UMDBPP/LVC/README.md

# LVC
Low Voltage Cutoff Hardware for LiPo Battery Protection
