UMDBPP/LVC/Rev6p1/CAD/render/lvc_3d_top.png

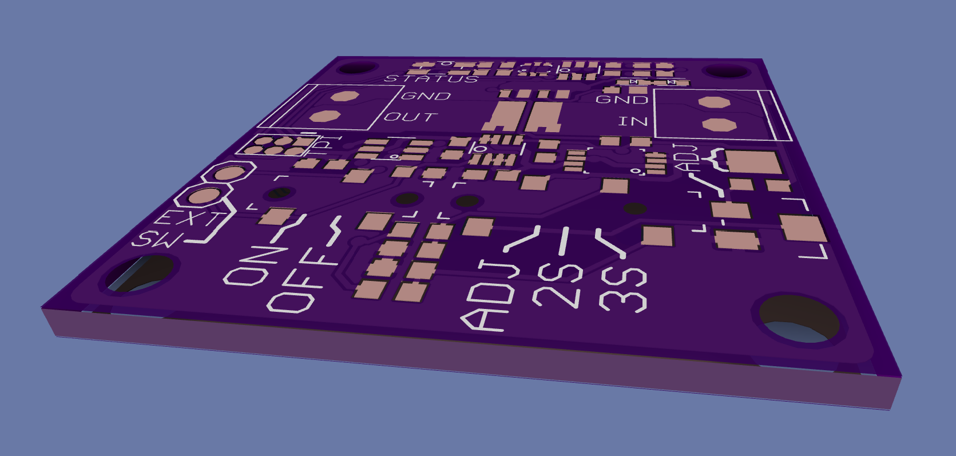
Rev6p1/CAD/render/lvc_3d_top.png
