UMDBPP/LVC/Rev6p1/CAD/render/lvc_bottom.png

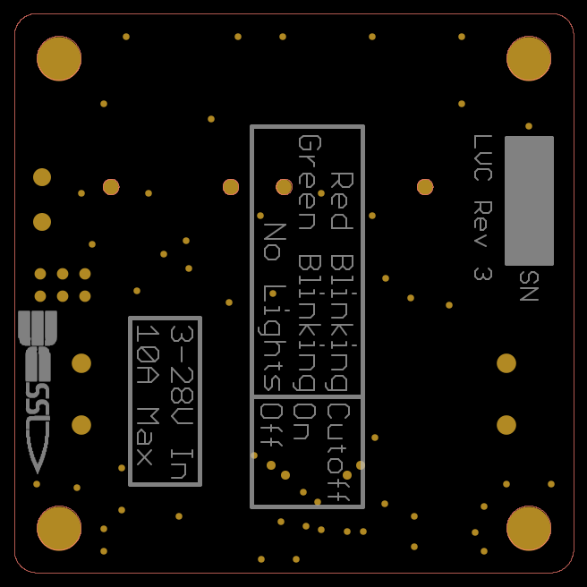
Rev6p1/CAD/render/lvc_bottom.png
