UMDBPP/LVC/Rev2025.0/LVC_Custom_BOM.xlsx

Country of Origin may be different at time of shipment.
The HTSUS and ECCN information shown is for informational purposes only and is not a representation or warranty as to the accuracy or reliability of these classifications. All information is provided "as is" and is subject to change without notice. Any use made of the information provided is without recourse to Digi-Key and at the user's risk.
Index | Manufacturer Part Number | Manufacturer Name | Description | Availability | Stock Status | Attrition % | Requested Quantity 1 | Pack Quantity 1 | Pack Type 1 | Digi-Key Part Number 1 | Unit Price 1 | Extended Price 1 | Minimum Order Quantity 1 | Customer Reference | Requested Part Number | Lead Weeks | Datasheet | Reference Designator | US Import Tariff | Note | Part Status | RoHS Status | Moisture Sensitivity Level (MSL) | ECCN | HTSUS | Country of Origin | Environmental Information | Original Part numbers | REACH Status | Unit of Measure | Image | Product Notes
1 | SMAZ10-13-F | Diodes Incorporated | DIODE ZENER 10V 1W SMA | 87,221 | In Stock |  | 1 | 1 | Cut Tape (CT) | SMAZ10-FDICT-ND | 0.31000 | $0.31 | 1 |  | SMAZ10-13-F | 12 | https://www.diodes.com/assets/Datasheets/ds18015.pdf |  | N/A |  | Active | ROHS3 Compliant | 1 (Unlimited) | EAR99 | 8541.10.0050 | Taiwan | https://www.diodes.com/assets/Quality-Reliability-Docs/Master_CofC.pdf | SMAZ10-13-F | REACH Unaffected | EACH | https://mm.digikey.com/Volume0/opasdata/d220001/medias/images/5787/31%7ESMA%7E%7E2-View-2.jpg
2 | 1812L300/24SLER | Littelfuse Inc. | PTC RESET FUSE 3.0A 24V 1812 | 2,307 | In Stock |  | 1 | 1 | Cut Tape (CT) | 18-1812L300/24SLERCT-ND | 2.07000 | $2.07 | 1 |  | 1812L300/24SLER | 13 | https://www.littelfuse.com/assetdocs/low-rho-datasheet-update?assetguid=b786faf0-de16-4763-9d22-6b8080943caf |  | N/A |  | Active | ROHS3 Compliant | 1 (Unlimited) | EAR99 | 8533.40.8070 | Taiwan |  | 1812L300/24SLER | REACH Unaffected | EACH | https://mm.digikey.com/Volume0/opasdata/d220001/medias/images/5596/MFG_1812L300_24SLER.jpg
3 | GSFC3415C | Good-Ark Semiconductor | MOSFET, P-CH, SINGLE, -4.00A, -2 | 10,102 | In Stock |  | 2 | 2 | Cut Tape (CT) | 4786-GSFC3415CCT-ND | 0.16000 | $0.32 | 1 |  | GSFC3415C | 16 | https://goodarksemi.com/docs/datasheets/mosfets/GSFC3415C.pdf |  | N/A |  | Active | ROHS3 Compliant | 1 (Unlimited) | EAR99 | 8541.29.0095 | China |  | GSFC3415C | REACH Unaffected | EACH | https://mm.digikey.com/Volume0/opasdata/d220001/medias/images/6145/MFG_4786_SOT-23.jpg
4 | CUS-13TB | Nidec Components Corporation | SWITCH SLIDE SP3T 300MA 4V | 26,326 | In Stock |  | 1 | 1 | Cut Tape (CT) | 563-1103-1-ND | 0.91000 | $0.91 | 1 |  | CUS-13TB | 10 | https://www.nidec-copal-electronics.com/e/catalog/switch/cus.pdf |  | N/A |  | Active | ROHS3 Compliant | 1 (Unlimited) | EAR99 | 8536.50.9050 | Vietnam |  | CUS-13TB | REACH Unaffected | EACH | https://mm.digikey.com/Volume0/opasdata/d220001/medias/images/852/CUS-13TB.jpg
5 | LT6703IDC-2#TRMPBF | Analog Devices Inc. | IC COMPARATOR 1 GEN PUR 3DFN | 929 | In Stock |  | 1 | 1 | Cut Tape (CT) | LT6703IDC-2#TRMPBFCT-ND | 2.75000 | $2.75 | 1 |  | LT6703IDC-2#TRMPBFCT-ND | 10 | https://www.analog.com/media/en/technical-documentation/data-sheets/670323fd.pdf |  | N/A |  | Active | ROHS3 Compliant | 1 (Unlimited) | EAR99 | 8542.39.0060 | Thailand | https://www.analog.com/media/en/material-declaration/LT6703IDC-2%23TRMPBF.PDF | LT6703IDC-2#TRMPBFCT-ND | REACH Unaffected | EACH | https://mm.digikey.com/Volume0/opasdata/d220001/medias/images/4994/505%7E05-08-1717%7EDC%7E3.JPG
6 | RN73H1JTTD1004B25 | KOA Speer Electronics, Inc. | RES 1M OHM 0.1% 1/10W 0603 | 21,518 | In Stock |  | 4 | 4 | Cut Tape (CT) | 2019-RN73H1JTTD1004B25CT-ND | 0.10000 | $0.40 | 1 |  | 2019-RN73H1JTTD1004B25CT-ND | 9 | https://www.koaspeer.com/pdfs/RN73H.pdf |  | N/A |  | Active | ROHS3 Compliant | 1 (Unlimited) | EAR99 | 8533.21.0030 | Japan | https://www.koaglobal.com/-/media/Files/KOA_Global/product/common/rohs/Certificate_of_RoHS_Compliance_July2024.pdf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|https://mm.digikey.com/Volume0/opasdata/d220001/medias/docus/5718/2019_KOA%20Speer%20RoHS3%20Statement.pdf | 2019-RN73H1JTTD1004B25CT-ND | REACH Unaffected | EACH | https://mm.digikey.com/Volume0/opasdata/d220001/medias/images/211/KOA-Speer-RN73H-0603.jpg
7 | RR0816P-154-D | Susumu | RES SMD 150K OHM 0.5% 1/16W 0603 | 177,041 | In Stock |  | 1 | 1 | Cut Tape (CT) | RR08P150KDCT-ND | 0.10000 | $0.10 | 1 |  | RR08P150KDCT-ND | 22 | https://www.susumu.co.jp/common/pdf/n_catalog_partition05_en.pdf |  | N/A |  | Active | ROHS3 Compliant | 1 (Unlimited) | EAR99 | 8533.21.0030 | Japan | https://www.susumu.co.jp/common/pdf/Certificate%20of%20EU%20RoHS%20compliance.pdf | RR08P150KDCT-ND | REACH Unaffected | EACH | https://mm.digikey.com/Volume0/opasdata/d220001/medias/images/2577/RR%200603%20SERIES.jpg
8 | ERA-3AEB683V | Panasonic Electronic Components | RES SMD 68K OHM 0.1% 1/10W 0603 | 20,290 | In Stock |  | 1 | 1 | Cut Tape (CT) | P68KDBCT-ND | 0.10000 | $0.10 | 1 |  | P68KDBCT-ND | 12 | https://industrial.panasonic.com/cdbs/www-data/pdf/RDM0000/AOA0000C307.pdf |  | N/A |  | Active | ROHS3 Compliant | 1 (Unlimited) | EAR99 | 8533.21.0030 | Japan | https://industrial.panasonic.com/cdbs/www-cgi/auto-publishing.cgi?type=ROSU&region=WW&layer=4&cd=AOA0026 | P68KDBCT-ND | REACH Unaffected | EACH | https://mm.digikey.com/Volume0/opasdata/d220001/medias/images/2391/10-0603%20Resistor.jpg
9 | ERA-3AEB4422V | Panasonic Electronic Components | RES SMD 44.2KOHM 0.1% 1/10W 0603 | 5,603 | In Stock |  | 1 | 1 | Cut Tape (CT) | 10-ERA-3AEB4422VCT-ND | 0.10000 | $0.10 | 1 |  | 10-ERA-3AEB4422VCT-ND | 12 | https://industrial.panasonic.com/cdbs/www-data/pdf/RDM0000/AOA0000C307.pdf |  | N/A |  | Active | ROHS3 Compliant | 1 (Unlimited) | EAR99 | 8533.21.0030 | Japan | https://industrial.panasonic.com/cdbs/www-cgi/auto-publishing.cgi?type=ROSU&region=WW&layer=4&cd=AOA0026 | 10-ERA-3AEB4422VCT-ND | REACH Unaffected | EACH | https://mm.digikey.com/Volume0/opasdata/d220001/medias/images/2391/10-0603%20Resistor.jpg
10 | RN73H1JTTD1002B25 | KOA Speer Electronics, Inc. | RES 10K OHM 0.1% 1/10W 0603 | 363,487 | In Stock |  | 1 | 1 | Cut Tape (CT) | 2019-RN73H1JTTD1002B25CT-ND | 0.10000 | $0.10 | 1 |  | 2019-RN73H1JTTD1002B25CT-ND | 9 | https://www.koaspeer.com/pdfs/RN73H.pdf |  | N/A |  | Active | ROHS3 Compliant | 1 (Unlimited) | EAR99 | 8533.21.0030 | Japan | https://www.koaglobal.com/-/media/Files/KOA_Global/product/common/rohs/Certificate_of_RoHS_Compliance_July2024.pdf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|https://mm.digikey.com/Volume0/opasdata/d220001/medias/docus/5718/2019_KOA%20Speer%20RoHS3%20Statement.pdf | 2019-RN73H1JTTD1002B25CT-ND | REACH Unaffected | EACH | https://mm.digikey.com/Volume0/opasdata/d220001/medias/images/211/KOA-Speer-RN73H-0603.jpg
11 | C0603C104K5RAC7411 | KEMET | CAP CER 0.1UF 50V X7R 0603 | 1,491,827 | In Stock |  | 1 | 1 | Cut Tape (CT) | 399-C0603C104K5RAC7411CT-ND | 0.08000 | $0.08 | 1 |  | 399-C0603C104K5RAC7411CT-ND | 20 | https://search.kemet.com/download/datasheet/C0603C104K5RAC7411 |  | N/A |  | Active | ROHS3 Compliant | 1 (Unlimited) | EAR99 | 8532.24.0020 | Mexico |  | 399-C0603C104K5RAC7411CT-ND | REACH Unaffected | EACH | https://mm.digikey.com/Volume0/opasdata/d220001/medias/images/5352/0603-%281608-Metric%29-Ceramic-Capacitor.jpg
