UMDBPP/LVC/tiny84/LVC_rev1/LVC_rev1_BOM.xlsx

UMD BPP Low Voltage Cutoff Rev 1.2 BOM
Item # | Ref Des | Qty | Manufacturer | Mfg Part # | Description | Package | Type | Dist. 1 | Dist. 1 Part No. | Dist. 2 | Dist. 2 Part No.
1 | C1 | 1 | Samsung EMA | CL31B475KBHNNNE | CAP CER 4.7UF 50V X7R 1206 | 1206 | SMD | Digi-Key | 1276-2789-1-ND
2 | C2 | 1 | Samsung EMA | CL21A106KOQNNNE | CAP CER 10UF 16V X5R 0805 | 0805 | SMD | Digi-Key | 1276-1096-1-ND
3 | C3 | 1 | Murata | GRM188R71E104KA01D | 0.10µF ±10% 25V X7R Ceramic Capacitor | 0603 | SMD | Digi-Key | 490-1524-1-ND
4 | LED1 | 1 | YETDA | 5060BRG4 | LED RGB Common Cathode |  | SMD | Sparkfun | COM-10866
5 | R1, 2, 3 | 3 |  |  | 1M, 0.1% | 0603 | SMD | Digi-Key | A102234CT-ND
6 | R4 | 1 |  |  | 1k, 5% | 0603 | SMD | Digi-Key | 311-1.0KGRCT-ND
7 | R5, 6, 7, 11, 12, 13 | 6 |  |  | 100k, 5% | 0603 | SMD | Digi-Key | 311-100KGRCT-ND
8 | R8, 9, 10 | 3 |  |  | 680, 5% | 0603 | SMD | Digi-Key | 1276-5058-1-ND
9 | U1 | 1 | Micrel | MIC5239-5.0YM | IC REG LDO 5V 0.5A 8SOIC | 8-SOIC | SMD | Digi-Key | 576-1838-5-ND
10 | U2 | 1 | Atmel | ATTINY84-20SSU | IC MCU 8BIT 8KB FLASH 14SOIC | 14-SOIC | SMD | Digi-Key | ATTINY84-20SSU-ND
11 | T1 | 1 | Diodes Incorporated | DMP4047SK3-13 | MOSFET P-CH 40V 20A TO252 | TO-252 | SMD | Digi-Key | DMP4047SK3-13DICT-ND
12 | T2, 4 | 2 | NXP | 2N7002P,215 | MOSFET N-CH 60V 0.36A SOT-23 | SOT23-3 | SMD | Digi-Key | 568-5818-1-ND
13 | T3 | 1 | Infineon | BSS84PH6327XTSA2 | MOSFET P-CH 60V 170MA SOT-23 | SOT23 | SMD | Digi-Key | BSS84PH6327XTSA2CT-ND
14 | S1, 2 | 2 | Sparkfun |  | SPDT Slide Switch |  | Thru-Hole | Sparkfun | COM-09609
15 | PRGM | 1 | Sparkfun | PRT-12807 | 6 Pin programming header |  | Thru-Hole | Sparkfun | PRT-12807
16 | J1 |  |  |  | 5 pin linear header 0.1" spacing |  |  |  | Do not populate
17
18
19
20
21
22
