UMDBPP/LVC/Rev6p1/CAD/eagle/lvc_schematic.pdf

Dividers | Screw Terminals

A

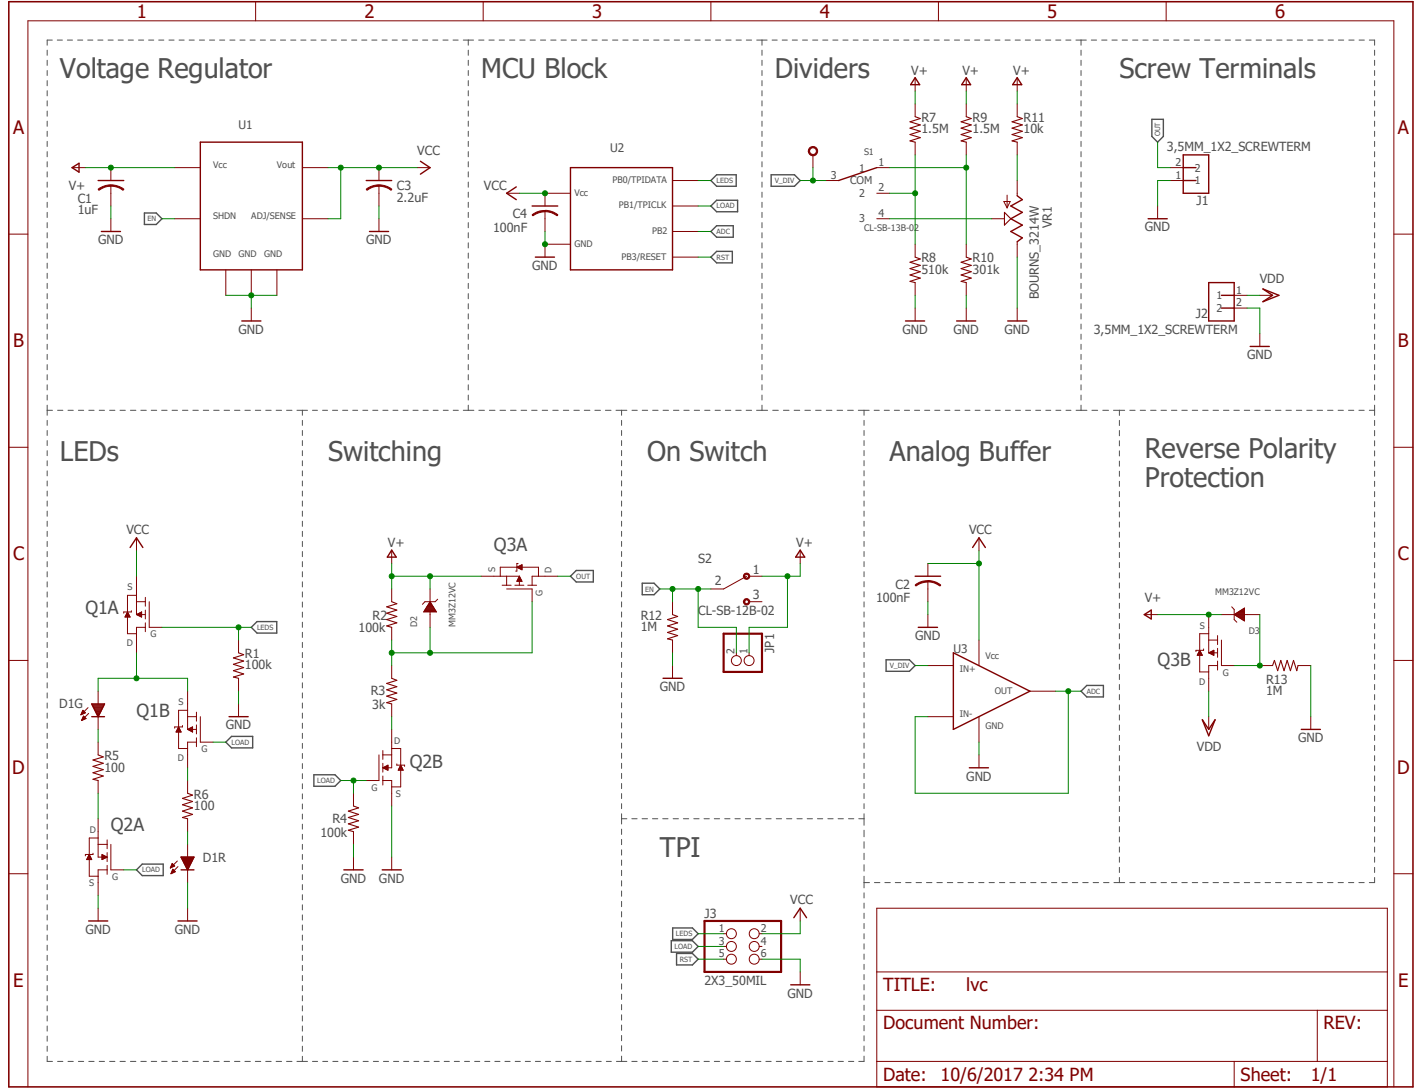
[picture p4: page 1]

Voltage Regulator MCU Block

Document Number: | REV:

Date: 10/6/2017 2:34 PM | Sheet: 1/1
