UMDBPP/LVC/Rev2025.0/LVC_Custom.kicad_pcb

## KiCad design Rev2025.0/LVC_Custom.kicad_pcb (2025-04-04)

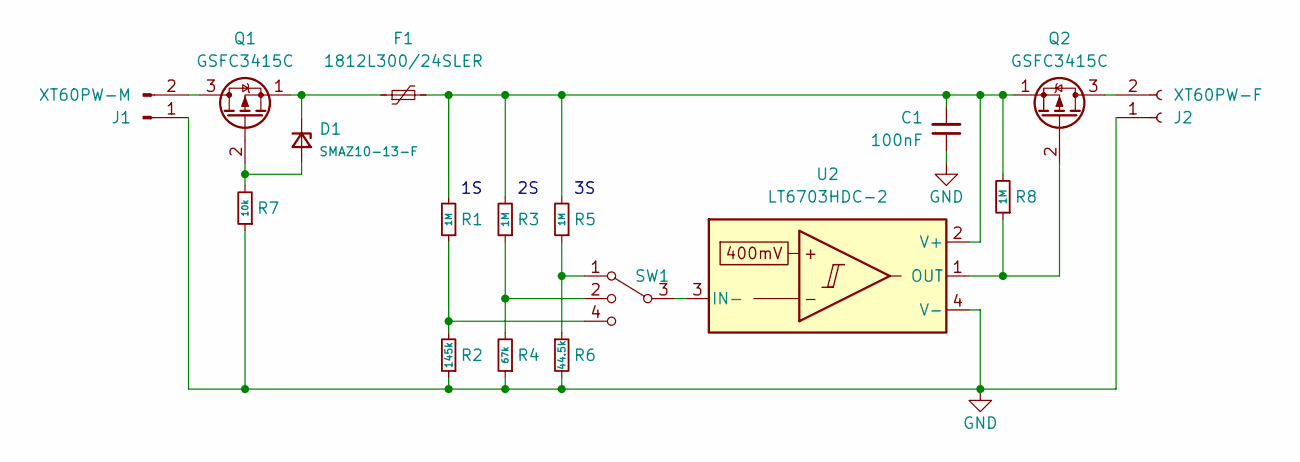
[picture p5: schematic LVC_Custom.kicad_sch, Low Voltage Cutoff]

Parts:
C1: 100nF; C_0603_1608Metric_Pad1.08x0.95mm_HandSolder
D1: SMAZ10-13-F; D_SMA_Handsoldering
F1: 1812L300/24SLER; Fuse_1812_4532Metric_Pad1.30x3.40mm_HandSolder
J1: XT60PW-M; AMASS_XT60PW-M_1x02_P7.20mm_Horizontal
J2: XT60PW-F; AMASS_XT60PW-F_1x02_P7.20mm_Horizontal
Q1, Q2: GSFC3415C; SOT-23-3
R1, R3, R5, R8: 1M; R_0603_1608Metric_Pad0.98x0.95mm_HandSolder
R2: 145k; R_0603_1608Metric_Pad0.98x0.95mm_HandSolder
R4: 67k; R_0603_1608Metric_Pad0.98x0.95mm_HandSolder
R6: 44.5k; R_0603_1608Metric_Pad0.98x0.95mm_HandSolder
R7: 10k; R_0603_1608Metric_Pad0.98x0.95mm_HandSolder
SW1: CUS-13TB; CUS-13TB_NDC
U2: LT6703HDC-2; DFN-3-1EP-2x2mm_P0.5mm_EP1x1.35mm

Connections:
GND: C1.1, J1.1, J2.1, R2.1, R4.1, R6.2, R7.1, U2.4 (V-)
unnamed: D1.2 (A), Q1.2 (G), R7.2
unnamed: D1.1 (K), F1.1, Q1.1 (S)
unnamed: J1.2, Q1.3 (D)
unnamed: J2.2, Q2.3 (D)
unnamed: Q2.2 (G), R8.1, U2.1 (OUT)
unnamed: C1.2, F1.2, Q2.1 (S), R1.2, R3.2, R5.2, R8.2, U2.2 (V+)
unnamed: R1.1, R2.2, SW1.4
unnamed: R3.1, R4.2, SW1.2
unnamed: R5.1, R6.1, SW1.1
unnamed: SW1.3, U2.3 (IN-)

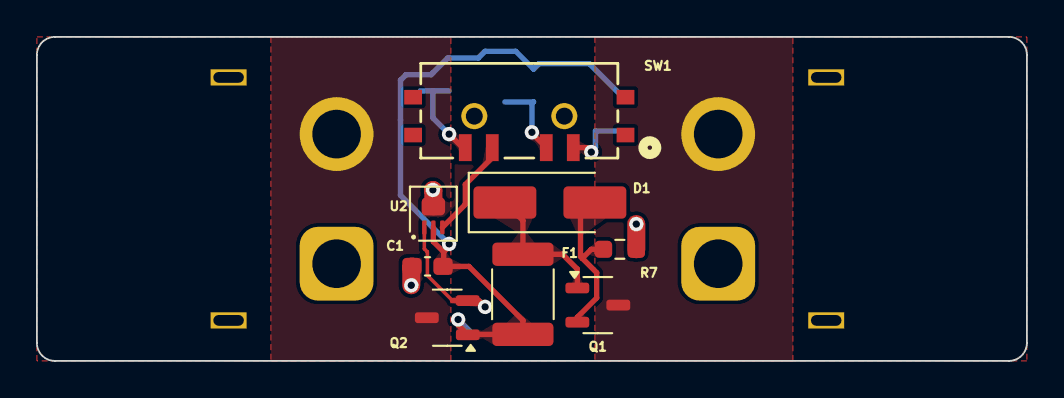
[picture p6: board LVC_Custom.kicad_pcb from above]

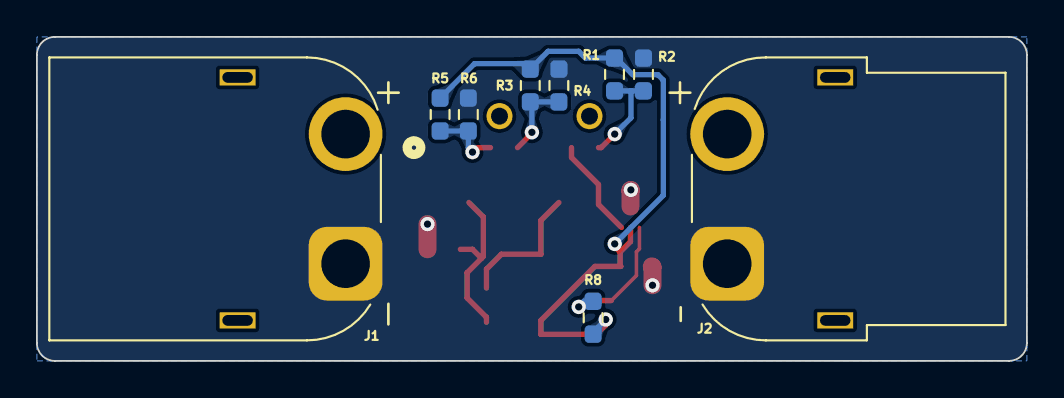
[picture p7: board LVC_Custom.kicad_pcb from below]

Board: 2 copper layers, 55.0 x 18.0 mm, 17 parts (9 on the bottom side), 11 nets.
