UMDBPP/LVC/Rev6p1/CAD/eagle/lvc.brd

## EAGLE design Rev6p1/CAD/eagle/lvc.brd (2018-05-23)

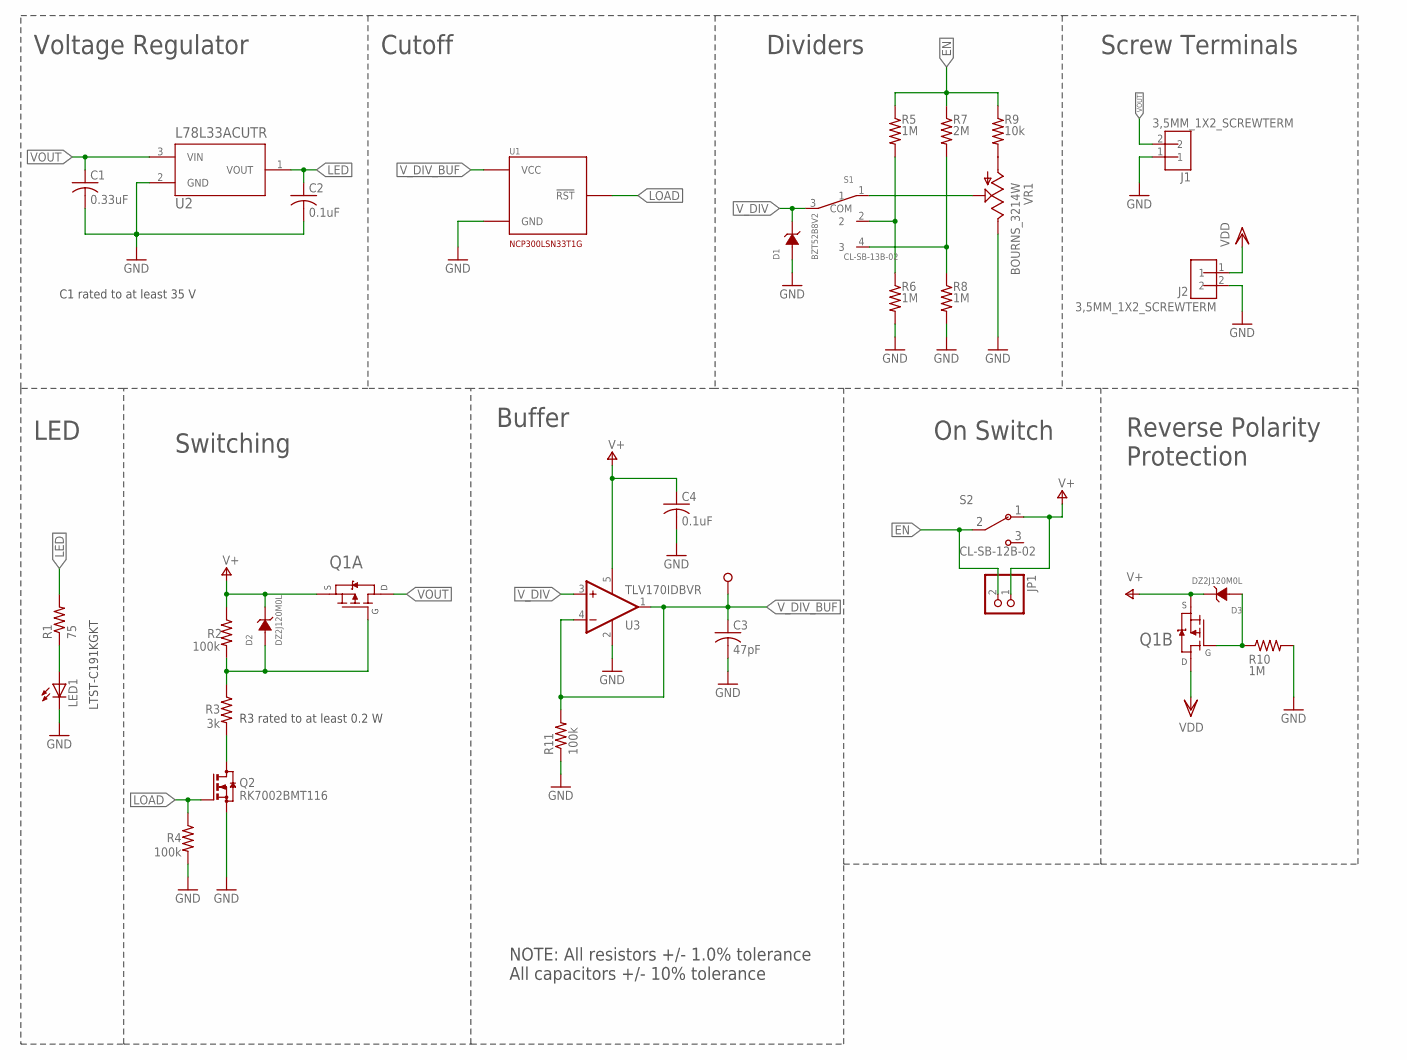
[picture p8: schematic lvc.sch]

Parts:
C1: 0.33uF; C0603
C2, C4: 0.1uF; C0603
C3: 47pF; C0603
D1: BZT52B8V2; SOD123
D2, D3: DZ2J120M0L; SMINI2-F5-B
J1, J2: 3,5MM_1X2_SCREWTERM; 3.5MM_1X2
JP1: PINHD-1X2; 1X02
LED1: LEDCHIPLED_0603; CHIPLED_0603
Q1: SI7997DP; POWERPAK-SO-8-DUAL
Q2: RK7002BMT116; SOT23
R1: 75; R0603
R2, R4, R11: 100k; R0603
R3: 3k; R0603
R5, R6, R8, R10: 1M; R0603
R7: 2M; R0603
R9: 10k; R0603
S1: CL-SB-13B-02; CL-SB-13B
S2: CL-SB-12B-02; CL-SB-12B
TP2: TESTPOINTNOCREAM; TP_2.5MM_NOCREAM
U1: NCP300LSN33T1G; SOT23-5
U2: L78L33ACUTR; SOT-89
U3: TLV170IDBVR; SOT23-DBV
VR1: BOURNS_3214W; J-LEAD_TOP_ADJ

Connections:
2_CELL: R5.2, R6.1, S1.2
3_CELL: R7.2, R8.1, S1.4 (3)
EN: JP1.2, R5.1, R7.1, R9.1, S2.1
GND: C1.2, C2.2, C3.2, C4.2, D1.A, J1.1, J2.2, LED1.C, Q2.2 (S), R4.2, R6.2, R8.2, R10.2, R11.1, U1.3 (GND), U2.2 (GND), U3.2 (V-), VR1.3 (E)
LED: C2.1, R1.2, U2.1 (VOUT)
LOAD: Q2.1 (G), R4.1, U1.1 (!RST!)
unnamed: LED1.A, R1.1
unnamed: D2.A, Q1.4 (G), R2.2, R3.1
unnamed: D3.A, Q1.2 (G), R10.1
unnamed: Q2.3 (D), R3.2
unnamed: S1.1, VR1.2 (S)
unnamed: R9.2, VR1.1 (A)
V+: C4.1, D2.C, D3.C, JP1.1, Q1.1 (S), Q1.3 (S), R2.1, S2.2, U3.5 (V+)
VDD: J2.1, Q1.7 (D), Q1.8 (D), Q1.8L (D)
VOUT: C1.1, J1.2, Q1.5 (D), Q1.5L (D), Q1.6 (D), U2.3 (VIN)
V_DIV: D1.C, S1.3 (COM), U3.3 (+IN)
V_DIV_BUF: C3.1, R11.2, TP2.P$1, U1.2 (VCC), U3.1 (OUT), U3.4 (-IN)

Notes on the sheet:
Voltage Regulator
LED
Switching
Dividers
Screw Terminals
On Switch
Reverse Polarity Protection
Cutoff
LTST-C191KGKT
NOTE: All resistors +/- 1.0% tolerance All capacitors +/- 10% tolerance
C1 rated to at least 35 V
R3 rated to at least 0.2 W
Buffer

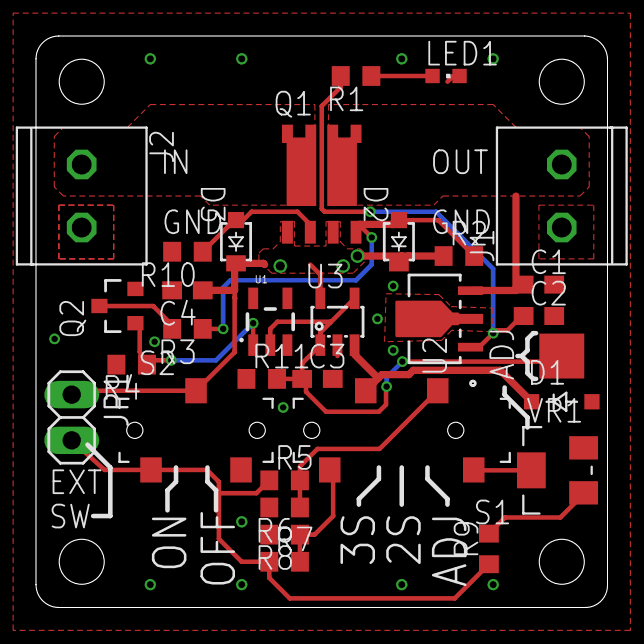
[picture p9: board lvc.brd from above]

Board: 2 copper layers, 31.8 x 31.8 mm, 31 parts (0 on the bottom side), 17 nets.
