UMDBPP/LVC/tiny5/CAD/eagle/lvc_1oz.brd

## EAGLE design tiny5/CAD/eagle/lvc_1oz.brd (2018-03-16)

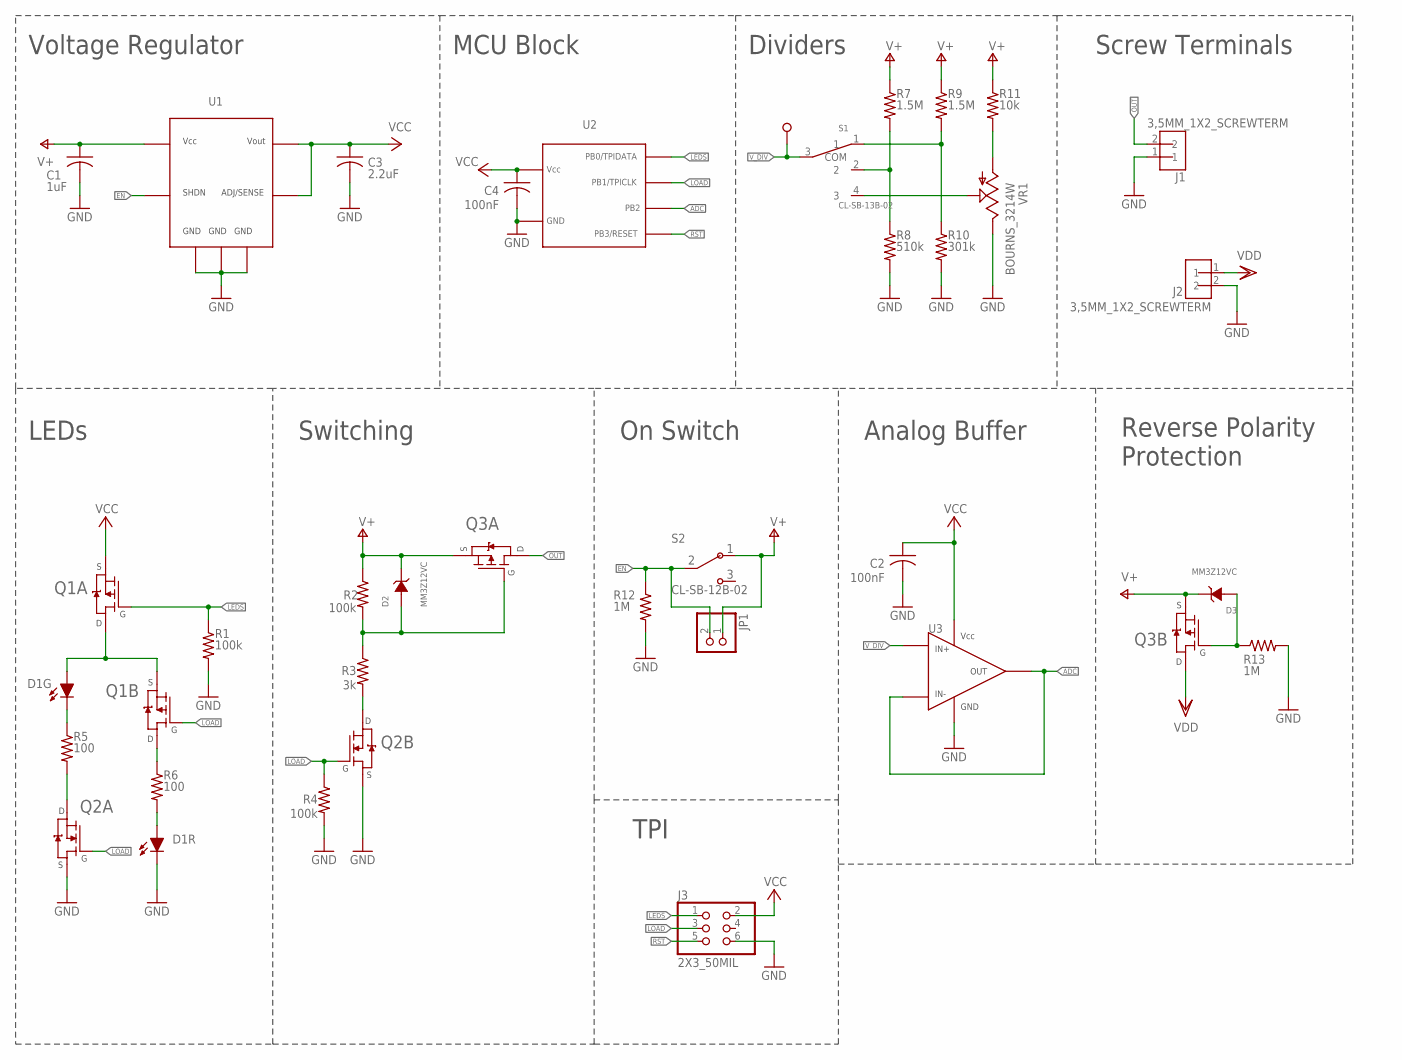
[picture p10: schematic lvc_1oz.sch]

Parts:
C1: 1uF; C0603
C2, C4: 100nF; C0603
C3: 2.2uF; C0603
D1: LED-R/G_150141RV73100; 4-PLCC
D2, D3: MM3Z12VC; SOD-323F
J1, J2: 3,5MM_1X2_SCREWTERM; 3.5MM_1X2
J3: 2X3_50MIL; 50MIL_2X3
JP1: PINHD-1X2; 1X02
Q1: FDC6312P; SOT23-6
Q2: PMGD280UN; 6-TSSOP
Q3: SI7997DP; POWERPAK-SO-8-DUAL
R1, R2, R4: 100k; R0603
R3: 3k; R0603
R5, R6: 100; R0603
R7, R9: 1.5M; R0603
R8: 510k; R0603
R10: 301k; R0603
R11: 10k; R0603
R12, R13: 1M; R0603
S1: CL-SB-13B-02; CL-SB-13B
S2: CL-SB-12B-02; CL-SB-12B
TP1: TESTPOINT; TP_2.5MM
U1: LT3007; SOT23-8
U2: ATTINY5; SOT23-6
U3: LT1494; 8-MSOP
VR1: BOURNS_3214W; J-LEAD_TOP_ADJ

Connections:
2_CELL: R7.2, R8.1, S1.2
3_CELL: R9.2, R10.1, S1.1
ADC: U2.4 (PB2), U3.P$2 (IN-), U3.P$6 (OUT)
ADJ: S1.4 (3), VR1.2 (S)
EN: JP1.2, R12.1, S2.1, U1.1 (SHDN)
GND: C1.2, C2.2, C3.2, C4.2, D1.3 (C), J1.1, J2.2, J3.6, Q2.P$1 (S), Q2.P$4 (S), R1.2, R4.2, R8.2, R10.2, R12.2, R13.2, U1.2 (GND1), U1.3 (GND2), U1.4 (GND3), U2.2 (GND), U3.P$4 (GND), VR1.3 (E)
LEDS: J3.1, Q1.1 (G), R1.1, U2.1 (PB0/TPID)
LOAD: J3.3, Q1.3 (G), Q2.P$2 (G), Q2.P$5 (G), R4.1, U2.3 (PB1/TPICLK)
unnamed: D1.4 (C), R5.1
unnamed: Q2.P$6 (D), R5.2
unnamed: D1.2 (A), Q1.2 (S), Q1.6 (D)
unnamed: Q1.4 (D), R6.1
unnamed: D2.1 (A), Q3.4 (G), R2.2, R3.1
unnamed: D3.1 (A), Q3.2 (G), R13.1
unnamed: Q2.P$3 (D), R3.2
unnamed: R11.2, VR1.1 (A)
OUT: J1.2, Q3.5 (D), Q3.5L (D), Q3.6 (D)
RA: D1.1 (A), R6.2
RST: J3.5, U2.6 (PB3/RST)
V+: C1.1, D2.2 (C), D3.2 (C), JP1.1, Q3.1 (S), Q3.3 (S), R2.1, R7.1, R9.1, R11.1, S2.2, U1.5 (VCC)
VCC: C2.1, C3.1, C4.1, J3.2, Q1.5 (S), U1.7 (OUT), U1.8 (ADJ/SENSE), U2.5 (VCC), U3.P$7 (VCC)
VDD: J2.1, Q3.7 (D), Q3.8 (D), Q3.8L (D)
V_DIV: S1.3 (COM), TP1.P$1, U3.P$3 (IN+)

Notes on the sheet:
Voltage Regulator
MCU Block
LEDs
Switching
Dividers
Screw Terminals
Analog Buffer
TPI
On Switch
Reverse Polarity Protection

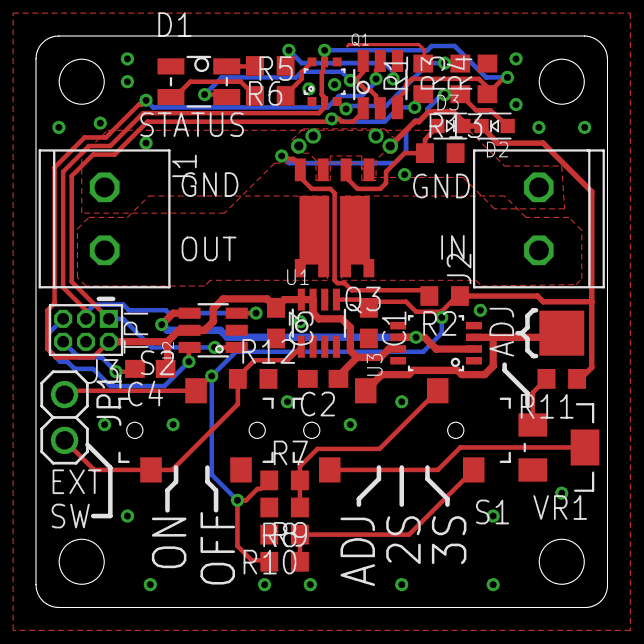
[picture p11: board lvc_1oz.brd from above]

Board: 2 copper layers, 31.8 x 31.8 mm, 34 parts (0 on the bottom side), 23 nets.
