UMDBPP/LVC/tiny84/LVC_rev1/LVC_rev1.brd

## EAGLE design tiny84/LVC_rev1/LVC_rev1.brd (2016-05-22)

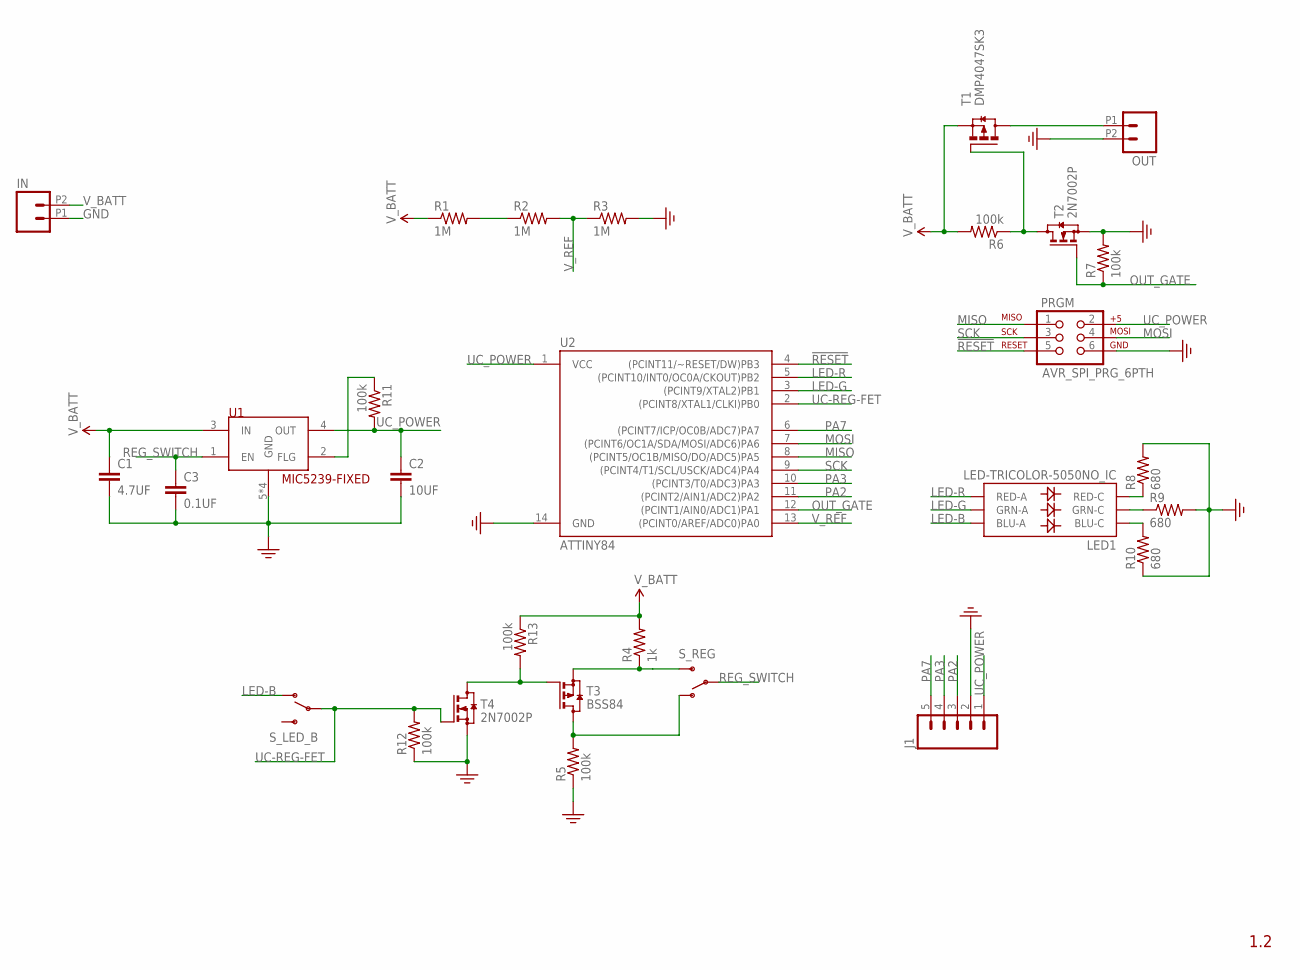
[picture p12: schematic LVC_rev1.sch]

Parts:
C1: 4.7UF; C1206
C2: 10UF; C0805
C3: 0.1UF; C0603
IN: M022.54MM_SCREWTERM; 1X02_2.54_SCREWTERM
J1: M05PTH; 1X05
LED1: LED-TRICOLOR-5050NO_IC; LED-TRICOLOR-5050
OUT: M022.54MM_SCREWTERM; 1X02_2.54_SCREWTERM
PRGM: AVR_SPI_PRG_6PTH; 2X3
R1, R2, R3: 1M; R0603
R4: 1k; R0603
R5, R6, R7, R11, R12, R13: 100k; R0603
R8, R9, R10: 680; R0603
S_LED_B: SWITCH-SPDTPTH; SWITCH-SPDT
S_REG: SWITCH-SPDTPTH; SWITCH-SPDT
T1: DMP4047SK3; TO252
T2, T4: 2N7002P; SOT23
T3: BSS84; SOT23
U1: MIC5239-FIXED; SOIC8
U2: ATTINY84; SO14

Connections:
!RESET: PRGM.5, U2.4 ((PCINT11/~RESET/DW)PB3)
BATT_OUT: OUT.P1 (1), T1.3 (D)
GND: C1.2, C2.2, C3.2, IN.P1 (1), J1.2, OUT.P2 (2), PRGM.6, R3.2, R5.1, R7.2, R8.2, R9.2, R10.1, R12.1, T2.2 (S), T4.2 (S), U1.5 (GND), U1.6 (GND), U1.7 (GND), U1.8 (GND), U2.14 (GND)
LED-B: LED1.3 (BLU-A), S_LED_B.1 (O)
LED-G: LED1.1 (GRN-A), U2.3 ((PCINT9/XTAL2)PB1)
LED-R: LED1.2 (RED-A), U2.5 ((PCINT10/INT0/OC0A/CKOUT)PB2)
MISO: PRGM.1, U2.8 ((PCINT5/OC1B/MISO/DO/ADC5)PA5)
MOSI: PRGM.4, U2.7 ((PCINT6/OC1A/SDA/MOSI/ADC6)PA6)
unnamed: LED1.6 (GRN-C), R9.1
unnamed: R4.1, S_REG.3 (S), T3.2 (S)
unnamed: R1.2, R2.1
unnamed: R5.2, S_REG.1 (O), T3.3 (D)
unnamed: R6.1, T1.1 (G), T2.3 (D)
unnamed: LED1.5 (RED-C), R8.1
unnamed: R11.1, U1.2 (FLG)
unnamed: LED1.4 (BLU-C), R10.2
unnamed: R13.2, T3.1 (G), T4.3 (D)
OUT_GATE: R7.1, T2.1 (G), U2.12 ((PCINT1/AIN0/ADC1)PA1)
PA2: J1.3, U2.11 ((PCINT2/AIN1/ADC2)PA2)
PA3: J1.4, U2.10 ((PCINT3/T0/ADC3)PA3)
PA7: J1.5, U2.6 ((PCINT7/ICP/OC0B/ADC7)PA7)
REG_SWITCH: C3.1, S_REG.2, U1.1 (EN)
SCK: PRGM.3, U2.9 ((PCINT4/T1/SCL/USCK/ADC4)PA4)
UC-REG-FET: R12.2, S_LED_B.2, T4.1 (G), U2.2 ((PCINT8/XTAL1/CLKI)PB0)
UC_POWER: C2.1, J1.1, PRGM.2, R11.2, U1.4 (OUT), U2.1 (VCC)
V_BATT: C1.1, IN.P2 (2), R1.1, R4.2, R6.2, R13.1, T1.2 (S), U1.3 (IN)
V_REF: R2.2, R3.1, U2.13 ((PCINT0/AREF/ADC0)PA0)

Notes on the sheet:
1.2

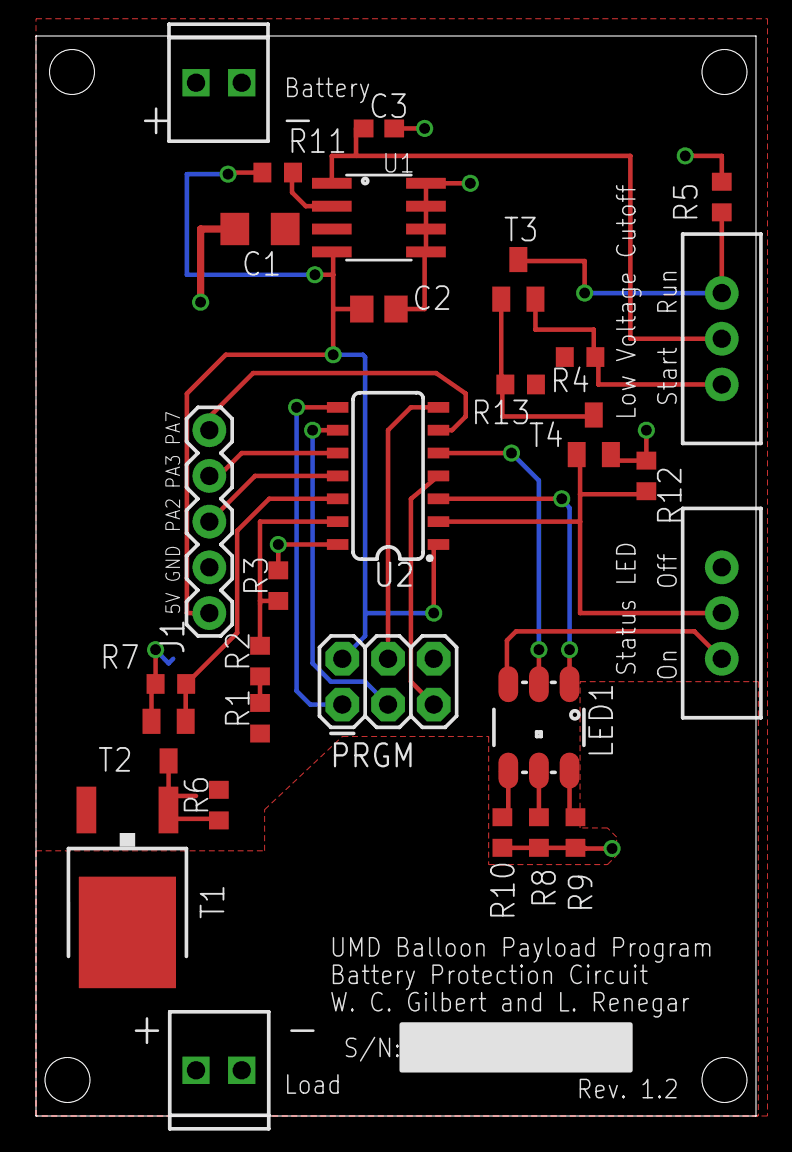
[picture p13: board LVC_rev1.brd from above]

Board: 2 copper layers, 40.0 x 60.0 mm, 29 parts (0 on the bottom side), 27 nets.
