UMDBPP/LVC/(commit log)

2016-05-21 Rev 1.2 - added C3 to fix start/run switch
2016-05-21 Updated BOM for rev 1.2
    [LVC_rev1_BOM.xlsx]
2016-05-22 Fixed via error
    [LVC_rev1.sch]
2016-05-22 Changed documentation error with T2
    [LVC_rev1.brd, LVC_rev1.sch]
2016-05-27 uploaded the current code for the LVC
2016-06-27 rewrote for AVR C, as Arduino is the devil.
2017-05-09 created directory structure for ATTiny5 revision
    [LVC_rev1.brd, LVC_rev1.sch, LVC_rev1_BOM.xlsx]
2017-05-09 adc initialization
2017-05-09 fixed potential error in lvc code
    [lvc.c]
2017-07-08 Added resistor.lbr
2017-07-09 added voltage reg library
2017-07-14 program fixed to be within 512 bytes
    [lvc.c]
2017-07-14 LDO added to schematic
    [lvc.sch]
2017-07-14 added mcu block, updated libraries
    [lvc.sch]
2017-07-14 Went from adjustable to fixed voltage reg.
    [lvc.sch]
2017-07-22 Added op amp
    [lvc.sch]
2017-07-22 Added pin 1 mark to 8-MSOP package
2017-07-22 Added slide switch part
2017-07-22 Added 3.5mm screw terminal part.
2017-07-22 Added zener diode.
2017-07-22 added low-rung shit tier dual n-channel mosfet
2017-07-22 Added low-rung shit tier dual P-Channel MOSFET
2017-07-23 Prettified MOSFET symbols
    [lvc.sch]
2017-07-23 Added LED
2017-07-23 Started layout
    [lvc.brd, lvc.sch]
2017-07-23 added 2-pos switch
2017-07-24 Finished routing
    [lvc.brd, lvc.sch]
2017-07-25 Prettified schematic
    [lvc.GBL, lvc.GBO, lvc.GBP, lvc.GBS, lvc.GKO, lvc.GTL, lvc.GTO, lvc.GTP]
2017-10-04 updated schematic for reverse polarity protection
    [lvc.GBL, lvc.GBO, lvc.GBP, lvc.GBS, lvc.GKO, lvc.GTL, lvc.GTO, lvc.GTP]
2017-10-05 yet another transistor (P-FET) update
    [lvc.brd, lvc.sch]
2017-10-06 Routed new transistor. Cleaned up transistor package definition
    [lvc.brd, lvc.sch]
2017-10-06 updated silkscreen, new renders, created gerbers
    [lvc.GBL, lvc.GBO, lvc.GBS, lvc.GKO, lvc.GTL, lvc.GTO, lvc.GTP, lvc.GTS]
2017-10-24 fixed bug in lvc code
    [lvc.c]
2018-03-10 1oz board
    [lvc_1oz.brd, lvc_1oz.sch]
2018-03-16 Added Rev4
    [lvc.brd, lvc.sch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]
2018-03-16 Updated voltage divider resistor values
    [lvc.brd, lvc.sch]
2018-03-19 Added comparator protection; cleaned up schematic
    [lvc.brd, lvc.sch]
2018-03-26 Added Rev4 final
    [lvc.brd, lvc.sch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]
2018-04-30 Initial pass at Rev6 with buffer
    Buffer required to prevent voltage divider from driving the NFET directly, because evidently a few microamps of bias current is enough to ruin somebody's day.
    [lvc.brd, lvc.sch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]
2018-05-02 Updated buffer to be upstream of comparator
    [lvc.brd, lvc.sch]
2018-05-07 Updated diode footprints
    [lvc.brd, lvc.sch]
2018-05-07 Cleaned up Gerbers
    [.drills.xln, gerber_job.gbrjob]
2018-05-22 Cleaned up component naming on Rev 1
    [lvc.brd, lvc.sch]
2018-05-22 Added rev 6.1; moved test point past buffer; cleaned up schematic
    Test point upstream of buffer caused observer effect due to multimeter input impedance
    [lvc.brd, lvc.sch]
2018-05-23 Updated revision text on board
    [lvc.brd]
2025-04-04 2025 LVC revision 0, simpler than previous verisions
    [LVC_Custom-B_Cu.gbl, LVC_Custom-B_Mask.gbs, LVC_Custom-B_Paste.gbp, LVC_Custom-B_Silkscreen.gbo, LVC_Custom-Edge_Cuts.gm1, LVC_Custom-F_Cu.gtl, LVC_Custom-F_Mask.gts, LVC_Custom-F_Paste.gtp]
